MIDORIINU/circuitos_de_pulsos/informe/bibliografia.tex

\begin{thebibliography}{9}

\bibitem{Wakerly4}
\Needspace*{7\baselineskip}
\emph{Digital Design: Principles and Practices (4\textsuperscript{th} Edition)}\\
Author: John F. Wakerly \\
Publisher: Pearson \\
Copyright: \textcopyright \space 2006, Pearson\\
ISBN 13: 9780131863897\\
Website: \weblink{https://www.pearson.com/us/higher-education/product/Wakerly-Digital-Design-Principles-and-Practices-4th-Edition/9780131863897.html}{Digital Design: Principles and Practices (4\textsuperscript{th} Edition)}\\

\bibitem{Taub_Schilling}
\Needspace*{7\baselineskip}
\emph{Electrónica digital integrada (1\textsuperscript{er} Edición)}\\
Author: Taub, Herbert \\
Author: Schilling, Donald \\
Publisher: Marcombo, S.A., Madrid \\
Copyright: \textcopyright \space 1980, Marcombo, S.A\\
ISBN 10: 8426703852\\
ISBN 13: 9788426703859\\
Website: \weblink{https://www.amazon.es/Electr\%C3\%B3nica-digital-integrada-Herbert-Taub/dp/B00PKRI1AE}{Electrónica digital integrada (1\textsuperscript{er} Edición)}\\

\bibitem{Sedra_Smith_ENG5}
\Needspace*{8\baselineskip}
\emph{Microelectronic circuits (5\textsuperscript{th} Edition)}\\
Author: Adel. S. Sedra\\
Author: Kenneth C. Smith\\
Publisher: Oxford, University press; 5\textsuperscript{th} Edition (2004)\\
Copyright: \textcopyright \space 2004, 1998, 1991, 1987, 1982, Oxford, University press Inc.\\
ISBN 10: 0195142527\\
Website: \weblink{http://www.oup.com/us/companion.websites/0195142519/}{Microelectronic circuits (5\textsuperscript{th} Edition)}\\

\end{thebibliography}
