MIDORIINU/circuitos_de_pulsos/informe/conclusiones.tex

\subsection{Dificultades encontradas}

El principal obstáculo fue la generación de la portadora con un ciclo de trabajo lo mas angosto posible, de modo de poder lograr pulsos de corriente alta y de corta duración en los LED infrarrojos, esto se solucionó con el circuito modificado del astable con el \textbf{NE555}. \\

Con el circuito ya funcionando adecuadamente se comprobó que aproximadamente a los  $10 \si[per-mode=symbol]{\meter}$ de cable, el funcionamiento circuito ya no era del todo confiable, habiendo ocasiones en que el código estaba corrupto y el equipo no respondía a los comandos, esto se solucionó reemplazando el \textbf{74HC04} inicialmente usado como buffer inversor por un \textbf{74HC14}, negador \textbf{schmitt trigger}, con colo este cambio, se pudo usar sin ningún problemas cable de mas de $30 \si[per-mode=symbol]{\meter}$.
