MIDORIINU/circuitos_de_pulsos/informe/objectives.tex

\subsection{Objetivo}

El objetivo del presente trabajo práctico es el diseño e implementación de un circuito digital discreto. Debería al menos cubrir algunos de los temas vistos en la materia, como ser lógica discreta de alguna de las familias expuestas, circuitos de tiempo, etc.\\

\subsection{Elección del tema del trabajo}

La elección o diseño de algún circuito digital, discreto, es decir que no incluya lógica programable, como ser micro-controladores, PAL, FPGA, etc, se hace complicado porque hoy día casi cualquier diseño incluye algo de esto. El circuito elegido se trata de un \textbf{repetidor de controles remotos infrarrojos}, el circuito permite mediante dos módulos, uno receptor y uno transmisor, controlar equipos con control remoto infrarrojo, aunque no se tenga línea de visión, por ejemplo si el equipo se encontrase en otra habitación. En la próxima sección se hace una breve explicación del funcionamiento de los controles infrarrojos comerciales para luego explicar el funcionamiento del circuito.
