MIDORIINU/circuitos_de_pulsos/informe/caratula.tex

\begin{titlepage}
%
% Sin cabecera ni pie de página:
%

\thispagestyle{empty}

 %Título:

	\begin{center}

   	\begin{figure}[H]
    		\centering
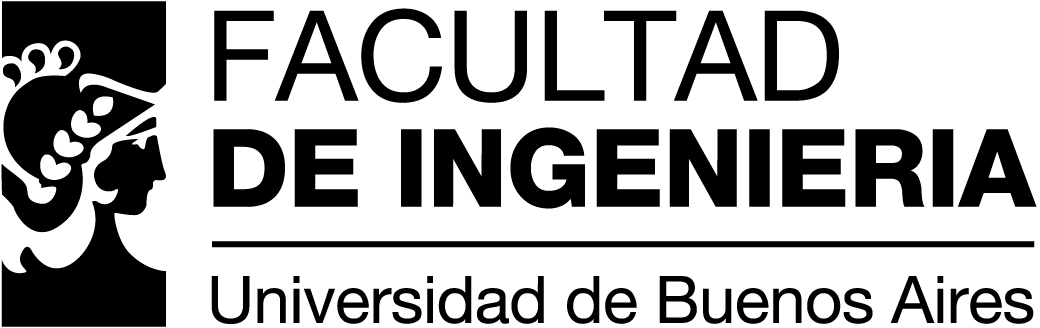
[picture p6: informe/img/fiuba.png]
    		
  	\end{figure}

		\vspace{1.2cm}

		\textsc{\huge \materia}\\
		\vspace{0.45cm}
		\Huge{\titulo}\\
		\HRule \\
		\vspace{0.15cm}
		\Large{\textbf{\titulolargo}}\\
		\HRule \\
		\vspace{0.15cm}

		\begin{flushleft}
			\begin{tabularx}{\textwidth}{@{\extracolsep{\fill}} ll|l}
				\emph{Alumnos:}&&\emph{Docentes:} \\
				\autorA & Padrón N\textdegree \space \padronA & \docenteA \\
				\mailA  &  & \docenteB \\
				        &  & \\
				        &  & \\				
				        &  & \\

%% \begin{normalsize}\textbf{(\textbf{*}) Docente asignado.}\end{normalsize}\\				        				
			\end{tabularx}
		\end{flushleft}

		\vfill
%        \vspace{0.1cm}
		% Bottom of the page
		{\Large \thedate}

	\end{center}

\end{titlepage}
