MIDORIINU/circuitos_de_pulsos/informe/datasheets.tex

%*********************************************

\subsection{IRM8601}
\label{datasheet_IRM86012}
\emph{\textbf{IRM8601}}\\
\emph{Infrared Receiver Module}\\
\vspace{5pt}
Manufacturer page: \weblink{http://www.everlight.com/SeriationProduct.aspx?Seq=bad52f62-2605-e411-8b3b-0002a54e500f}{http://www.everlight.com/SeriationProduct.aspx?Seq=bad52f62-2605-e411-8b3b-0002a54e500f}\\
Manufacturer Datasheet: \weblink{http://www.everlight.com/file/ProductFile/IRM-3636T.pdf}{http://www.everlight.com/file/ProductFile/IRM-3636T.pdf}\\

\subsection{NE555}
\label{datasheet_NE555}
\emph{\textbf{NE555}}\\
\emph{Single Precision Timer }\\
\vspace{5pt}
Manufacturer page: \weblink{http://www.ti.com/product/NE555/samplebuy?keyMatch=NE555&tisearch=Search-EN-Everything}{NE555}\\
Manufacturer Datasheet: \weblink{http://www.ti.com/lit/gpn/NE555}{http://www.ti.com/lit/gpn/NE555}\\

\subsection{74HC04}
\label{datasheet_74HC04}
\emph{\textbf{74HC04}}\\
\emph{Hex Inverters}\\
\vspace{5pt}
Manufacturer page: \weblink{http://www.ti.com/product/SN74HC04A?keyMatch=74HC04&tisearch=Search-EN-everything&usecase=part-number}{SN74HC04A}\\

\subsection{74HC14}
\label{datasheet_74HC14}
\emph{\textbf{74HC14}}\\
\emph{Hex Schmitt-Trigger Inverters }\\
\vspace{5pt}
Manufacturer page: \weblink{http://www.ti.com/product/SN74HC14A?keyMatch=74HC14&tisearch=Search-EN-everything&usecase=part-number}{SN74HC14A}\\
