MIDORIINU/circuitos_de_pulsos/informe/TP_Final_Informe.tex

\input{config}

%\\\\\\\\\\\\\\\\\\\\\\\\\\\\\\\

%-------------------------------------------------
%--------------- BEGIN DOCUMENT ------------------
%-------------------------------------------------
\begin{document}

%\\\\\\\\\\\\\\\\\\\\\\\\\\\
%Incluyo la caratula
%Caratula
\input{caratula}
\thispagestyle{empty}
\cleardoublepage
%\\\\\\\\\\\\\\\\\\\\\\\\\\\
	
%\\\\\\\\\\\\\\\\\\\\\\\\\\\
%Reinicio la cuenta y seteo el estilo de headers y footers.
\pagestyle{indexstyle}
\pagenumbering{Roman}
\setcounter{page}{1}
%\\\\\\\\\\\\\\\\\\\\\\\\\\\

%\\\\\\\\\\\\\\\\\\\\\\\\\\\
\begin{small}
\tableofcontents 
\addcontentsline{toc}{section}{Índice}
%\phantomsection\pdfbookmark[0]{\indexname}{bookmarkForTheIndex}

\clearpage

\listoffigures

%%\clearpage

%%\listoftables

\end{small}

\cleardoublepage
%\\\\\\\\\\\\\\\\\\\\\\\\\\\

%\\\\\\\\\\\\\\\\\\\\\\\\\\\
%Reinicio la cuenta y seteo el stilo de headers y footers.
\pagestyle{allpages}
\setcounter{page}{1}
\pagenumbering{arabic}
%\\\\\\\\\\\\\\\\\\\\\\\\\\\

%\\\\\\\\\\\\\\\\\\\\\\\\\\\
\section{Objetivos}
\resetallcounters
\input{objectives}
\clearpage
%\\\\\\\\\\\\\\\\\\\\\\\\\\\

%\\\\\\\\\\\\\\\\\\\\\\\\\\\
\section{Controles remotos infrarrojos}
\resetallcounters
\input{concept}
\clearpage
%\\\\\\\\\\\\\\\\\\\\\\\\\\\

%\\\\\\\\\\\\\\\\\\\\\\\\\\\
\section{Diseño circuital}
\resetallcounters
\input{design}
\clearpage
%\\\\\\\\\\\\\\\\\\\\\\\\\\\

%\\\\\\\\\\\\\\\\\\\\\\\\\\\
\section{Implementación del circuito}
\resetallcounters
\input{implementation}
\clearpage
%\\\\\\\\\\\\\\\\\\\\\\\\\\\

%\\\\\\\\\\\\\\\\\\\\\\\\\\\
\section{Observaciones y conclusiones}
\resetallcounters
\input{conclusiones}
\cleardoublepage
%\\\\\\\\\\\\\\\\\\\\\\\\\\\

%\\\\\\\\\\\\\\\\\\\\\\\\\\\
%Reinicio la cuenta y seteo el estilo de headers y footers.
\pagestyle{bibliostyle}
%\\\\\\\\\\\\\\\\\\\\\\\\\\\

%\\\\\\\\\\\\\\\\\\\\\\\\\\\
\section{Bibliografía}
\resetallcounters
\input{bibliografia}
\cleardoublepage
%\\\\\\\\\\\\\\\\\\\\\\\\\\\

%\\\\\\\\\\\\\\\\\\\\\\\\\\\
%Seteo el stilo de headers y footers.
\pagestyle{allpages}
%\\\\\\\\\\\\\\\\\\\\\\\\\\\

\appendix

\appendixpage
\addappheadtotoc

%\\\\\\\\\\\\\\\\\\\\\\\\\\\

\section{Hojas de datos}

\input{datasheets}

\clearpage
%\\\\\\\\\\\\\\\\\\\\\\\\\\\

\end{document}
