MIDORIINU/circuitos_de_pulsos/informe-compilado/Circuitos_completos.pdf

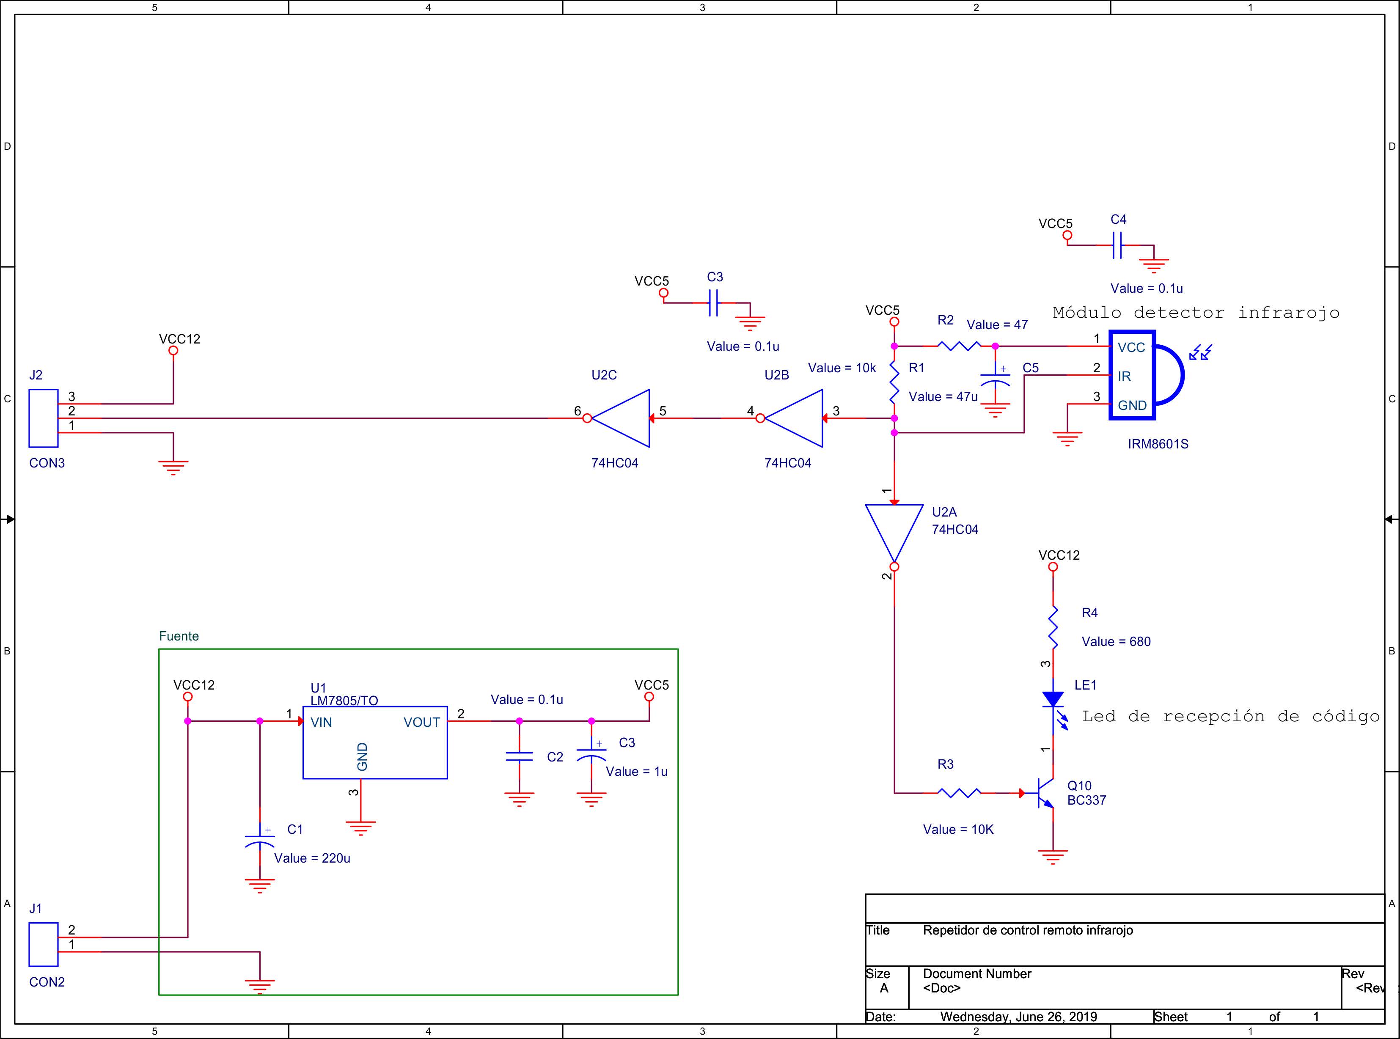
[picture p25: page 1]
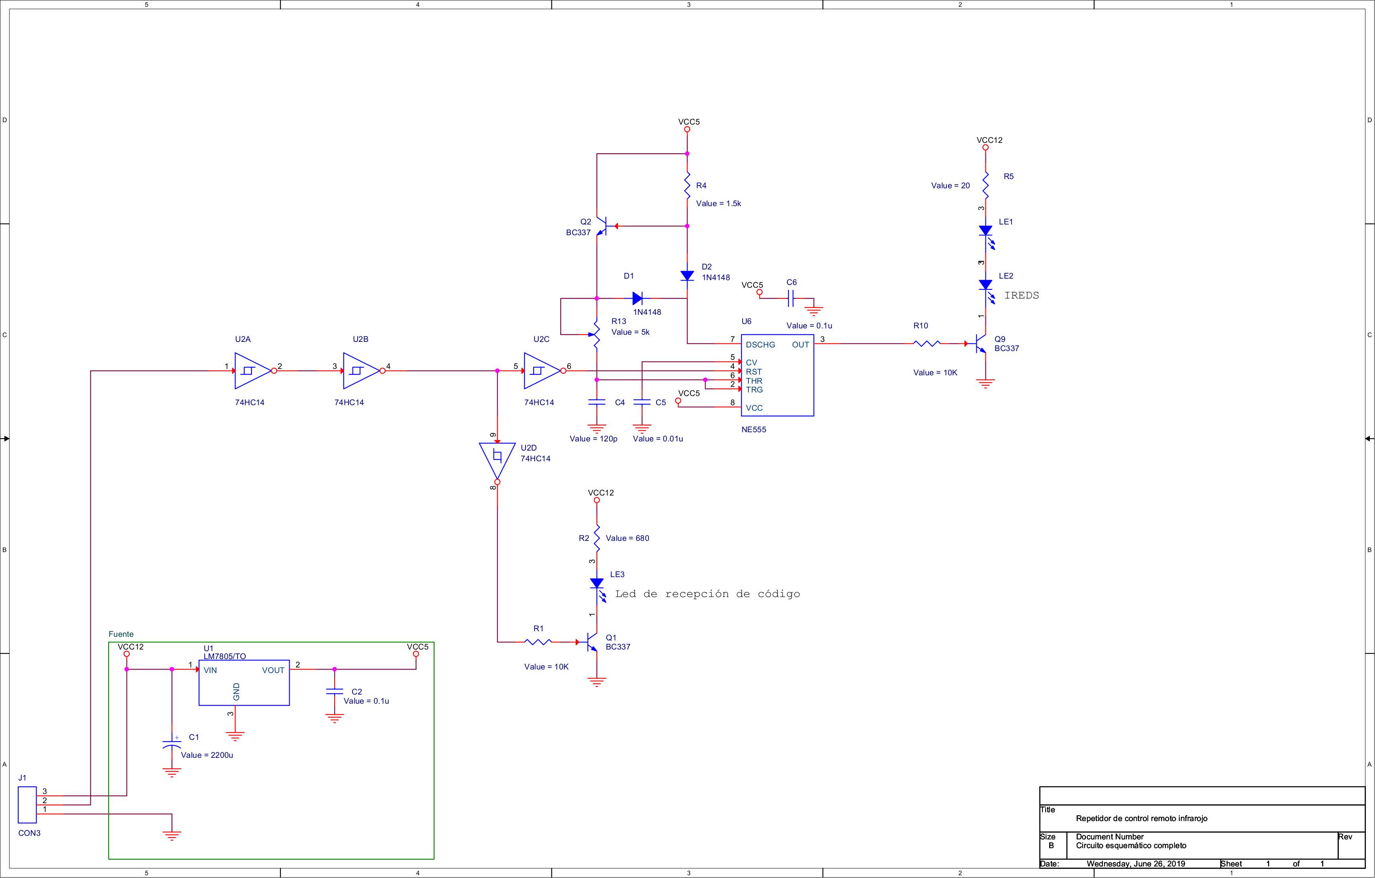
[picture p26: page 2]
