MIDORIINU/circuitos_de_pulsos/informe/img/IR/modulation_1.png

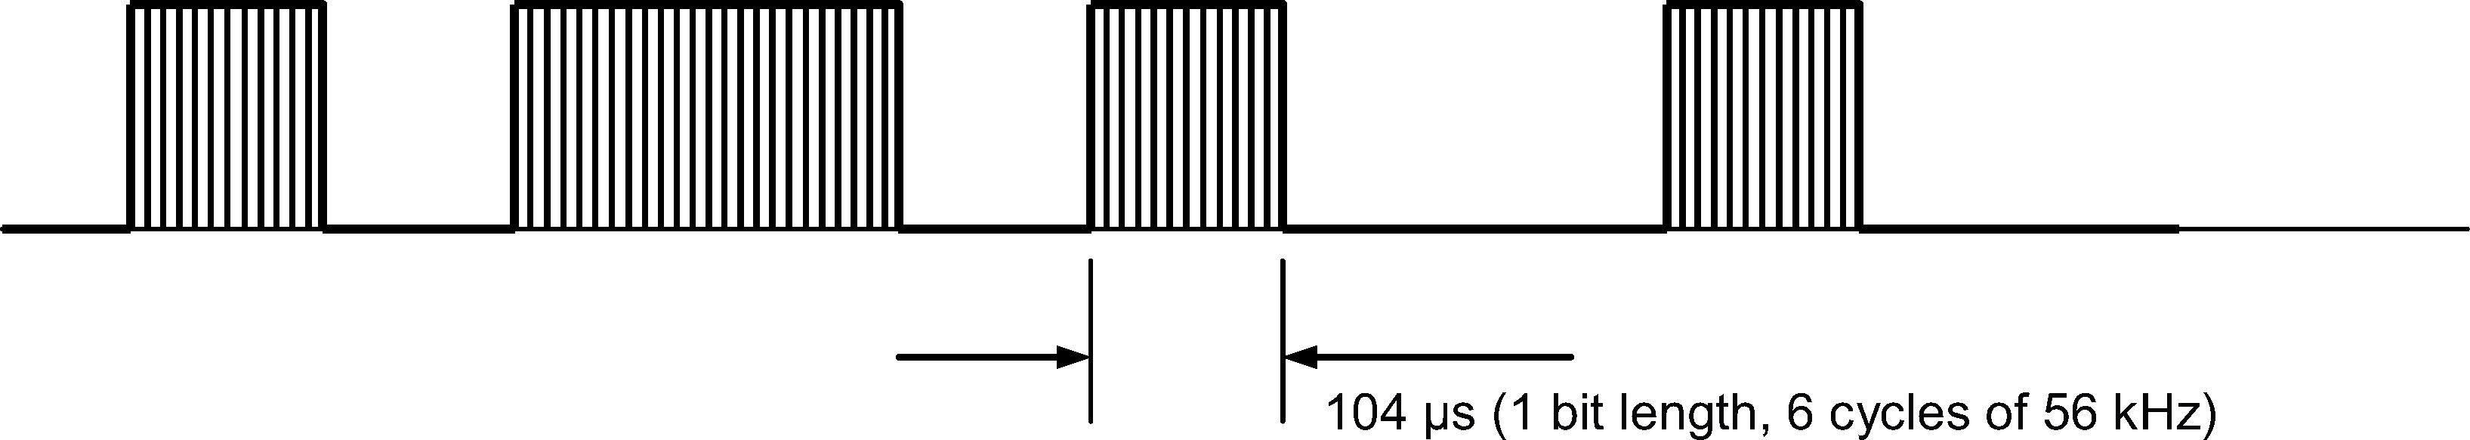
informe/img/IR/modulation_1.png
