MIDORIINU/circuitos_de_pulsos/informe/img/IR/RC5.png

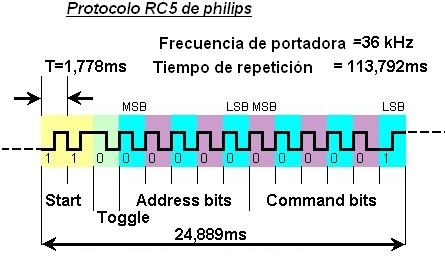
informe/img/IR/RC5.png
