MIDORIINU/circuitos_de_pulsos/informe/img/IR/remote-control-demodulated.png

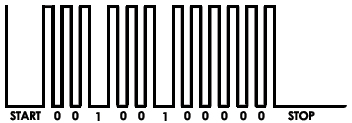
informe/img/IR/remote-control-demodulated.png
