MIDORIINU/circuitos_de_pulsos/informe/img/IR/words.png

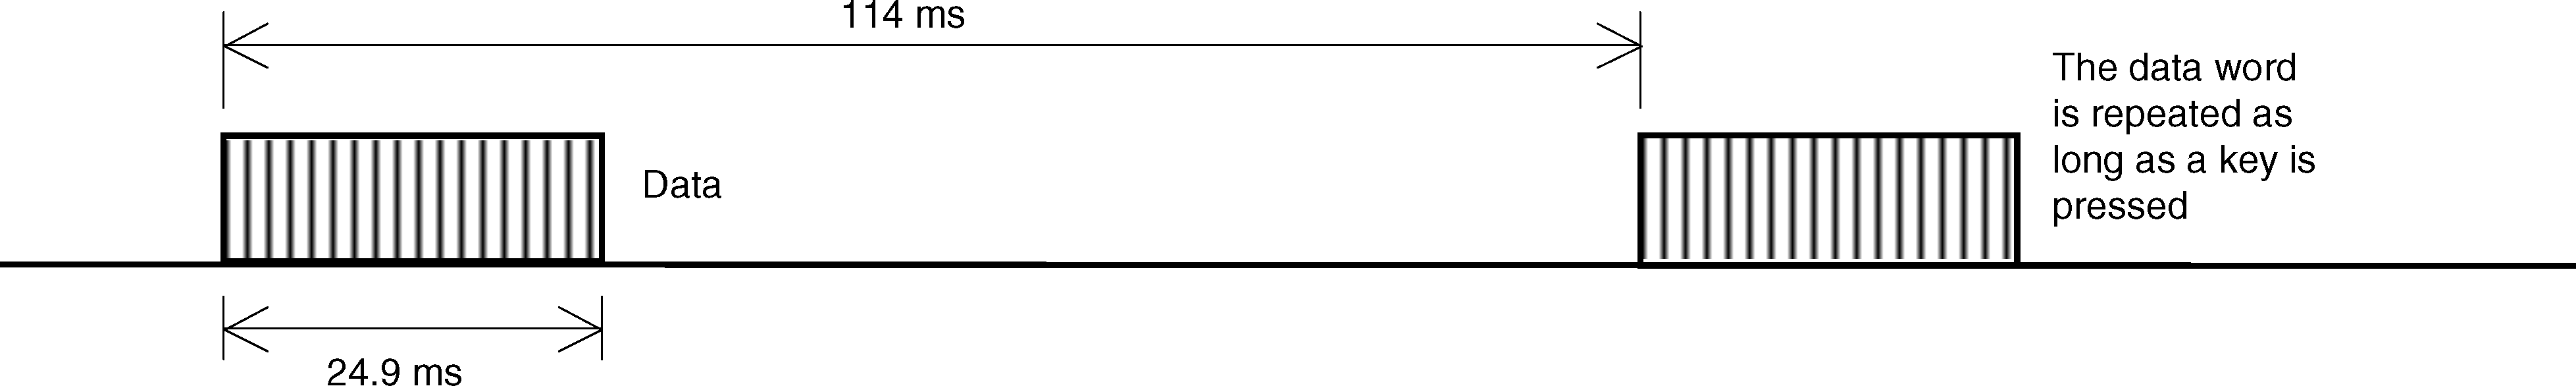
informe/img/IR/words.png
