MIDORIINU/circuitos_de_pulsos/informe/img/REAL/20190801_013701.jpg

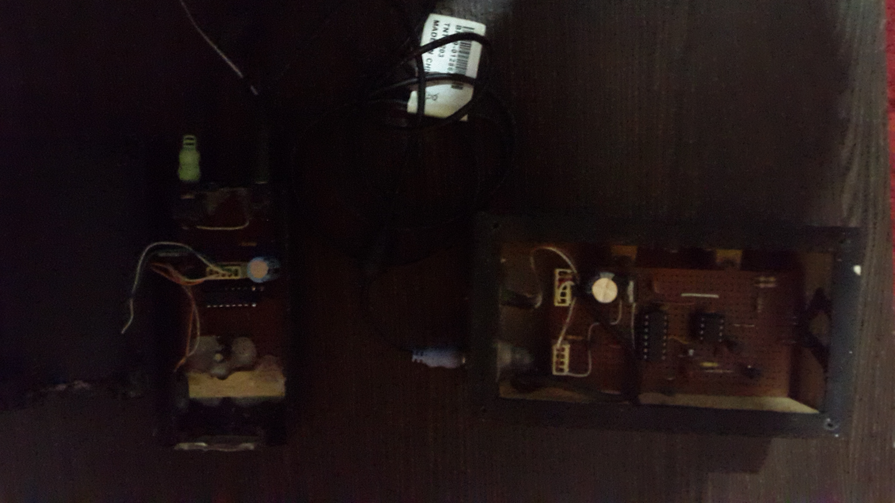
informe/img/REAL/20190801_013701.jpg
