MIDORIINU/circuitos_de_pulsos/informe/img/REAL/20190801_013746.jpg

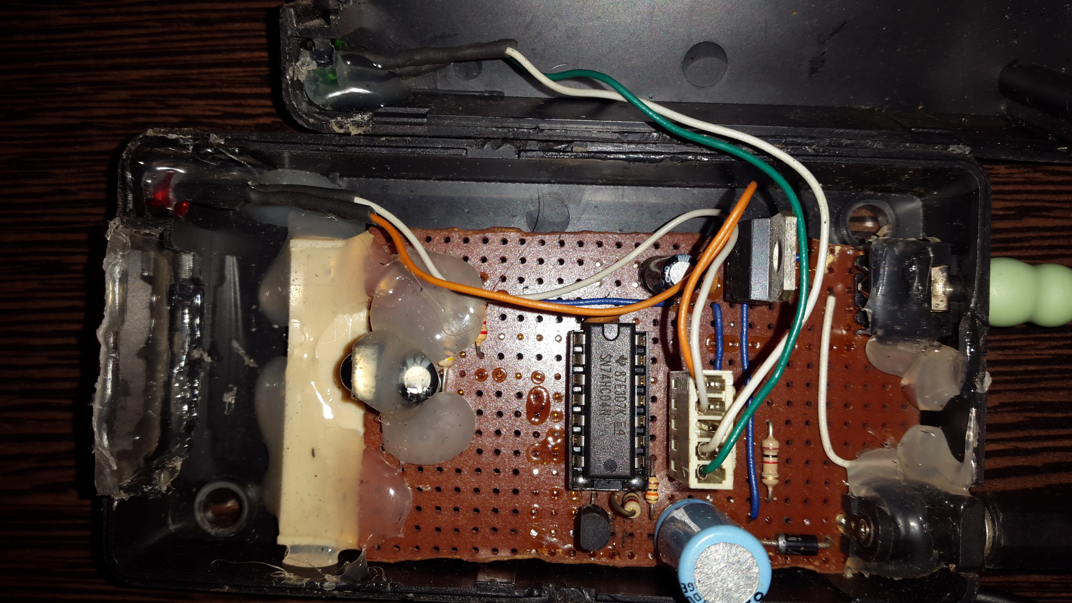
informe/img/REAL/20190801_013746.jpg
