MIDORIINU/circuitos_de_pulsos/SCH/SCHEMATIC1 _ PAGE1.pdf

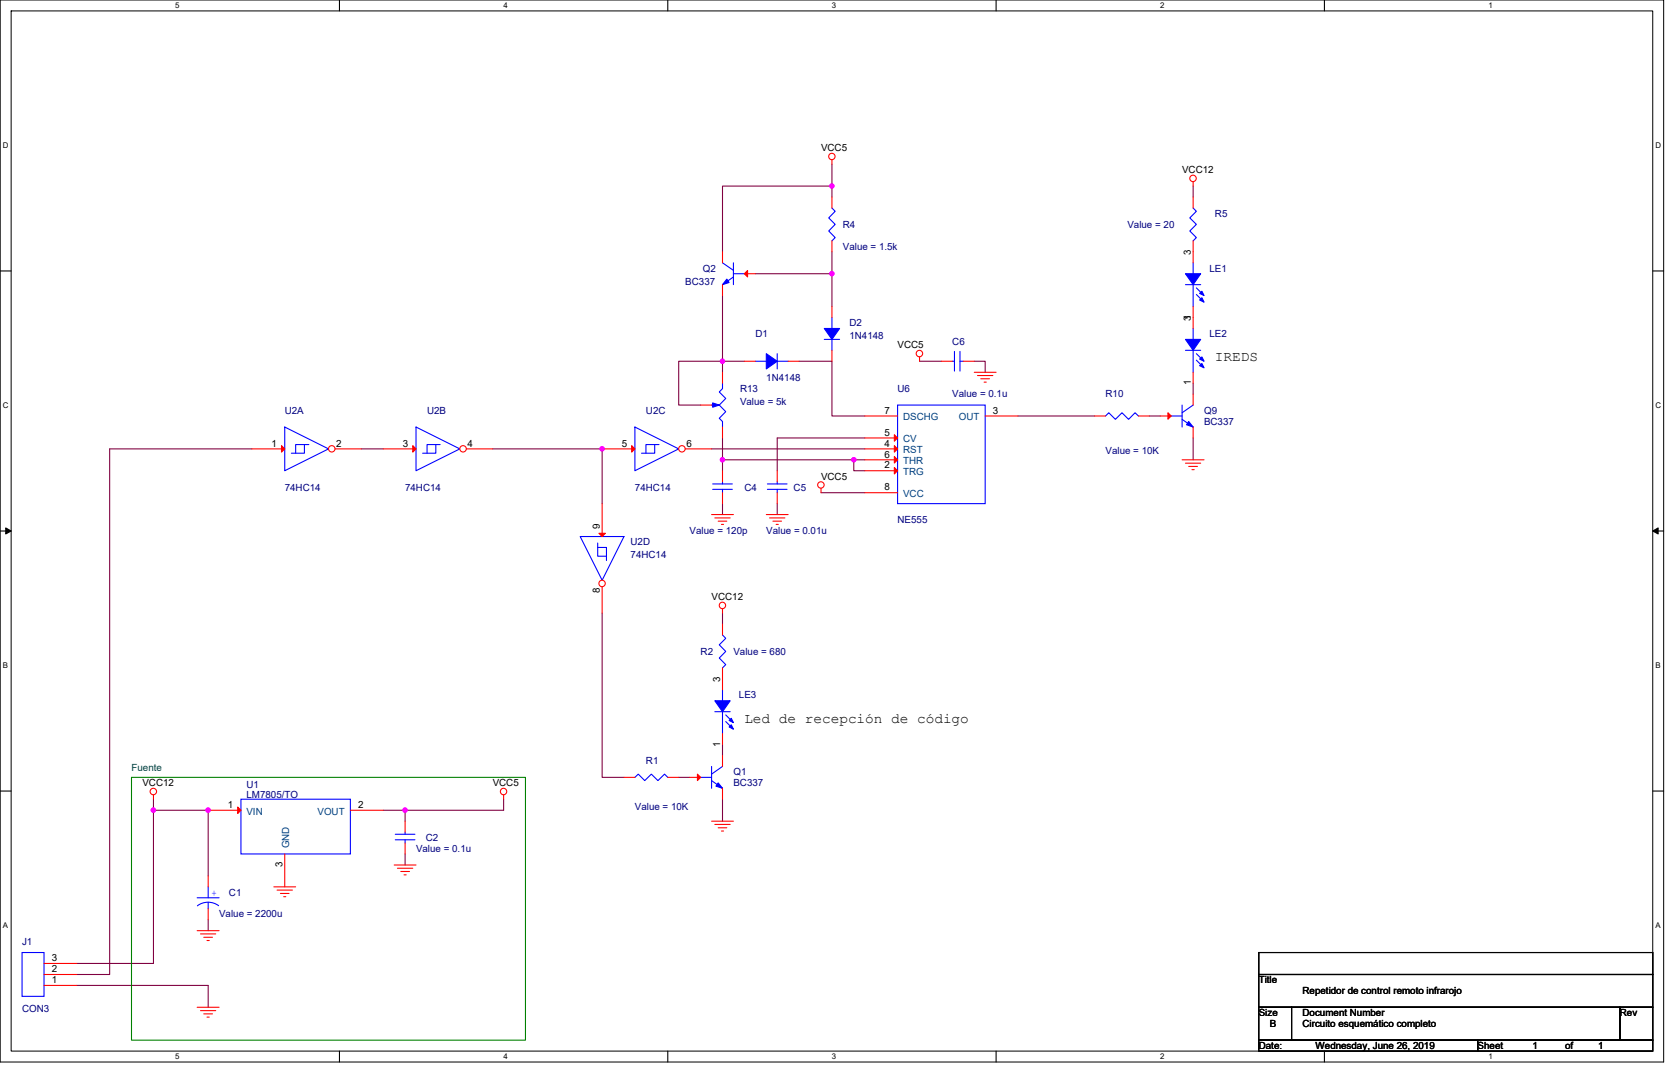
[picture p36: page 1]

Repetidor de control remoto infrarojo

Size Size Size B B B | Document Number Document Number Document Number Circuito esquemático completo Circuito esquemático completo Circuito esquemático completo | Rev Rev Rev

Date: Date: Date: Wednesday, June 26, 2019 Wednesday, June 26, 2019 Wednesday, June 26, 2019 | Sheet Sheet Sheet 1 1 1 of of of 1 1 1
