MIDORIINU/circuitos_de_pulsos/SCH/SCHEMATIC1 _ PAGE2.pdf

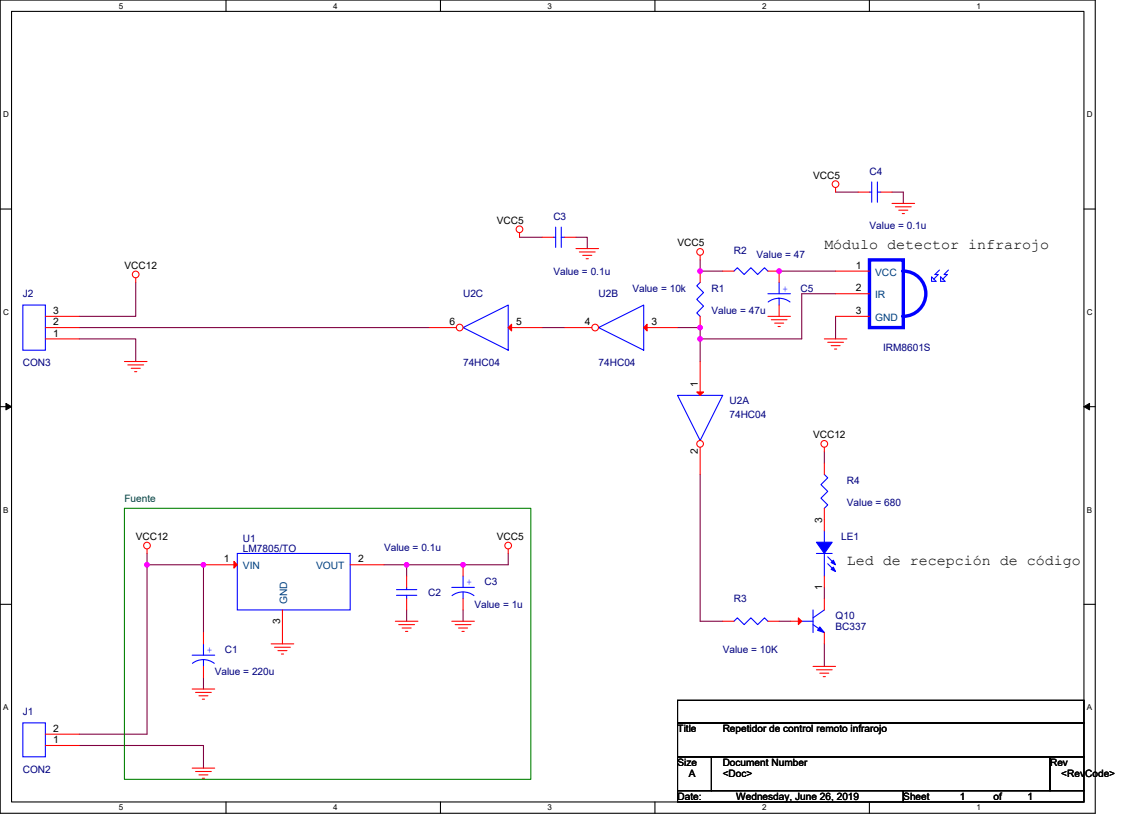
[picture p37: page 1]

Repetidor de control remoto infrarojo

Size Size Size A A A | Document Number Document Number Document Number | Rev Rev Rev

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
