MIDORIINU/circuitos_de_pulsos/(list of files, drawings)

Other design files:
SCH/F1.OPJ
SCH/IR REMOTE.DSN
SCH/IR REMOTE.opj
SCH/LIBRARY1.OLB
