MIDORIINU/circuitos_de_pulsos/(commit log)

2019-07-30 Inicio el repositiorio con el circuito en Orcad.
    [F1.OPJ, IR REMOTE.DSN, IR REMOTE.opj, LIBRARY1.OLB]
2019-08-01 Cerrando el informe.
2019-08-01 Informe completo, listo para entregar.
